DavidZamoraB/faronet/docs/kickoff/Kickoff_FaroNet.docx

Tecnológico de Costa Rica

Ingeniería en Computación · Redes de Computadoras

Proyecto 1: FaroNet

Documento de kick-off

Profesor: Kevin Moraga

Integrantes: David Zamora, Diego Zamora

Octubre, 2026

# 1. Introducción

FaroNet es una red de comunicación construida desde el hardware hasta la aplicación, cuyo objetivo es que las personas puedan conversar sin revelar quién habla con quién. Hoy no basta con cifrar el contenido de un mensaje: los metadatos (origen, destino, hora, frecuencia) también exponen a las personas, y el proyecto busca protegerlos.

El proyecto pide cuatro piezas que se apoyan una sobre otra:

1. El Faro: un dispositivo soldado que transmite y recibe datos usando luz, conectado por USB a una computadora.
2. Un protocolo de enlace propio: tramas de máximo 128 bytes con verificación de errores, control de acceso al medio, versión y una dirección física que puede rotarse.
3. Una red mesh anónima (FaroNet): enruta paquetes por Ethernet, WiFi o el Faro, con cifrado por capas (tipo onion routing) para que ningún nodo intermedio conozca a la vez el origen y el destino.
4. Una salida a Internet en el edge: un gateway que publica solo los mensajes públicos en Cloudflare Workers (salas en tiempo real, feeds, buzón muerto y directorio de nodos), sin guardar datos que identifiquen a los usuarios.

Todo el diseño se documenta en un RFC con consideraciones de privacidad y de seguridad.

## Estrategia de solución

El equipo parte con poca experiencia en casi todas las áreas del proyecto (ver sección 2). Por eso la estrategia es construir de abajo hacia arriba, validando cada capa antes de pasar a la siguiente, y aprender cada tema justo antes de necesitarlo:

1. Fase 0: aprendizaje base (electrónica, Arduino, sockets, criptografía con bibliotecas).
2. Fase 1: prototipo del Faro en protoboard, luz entre dos Faros.
3. Fase 2: Capa 1 (trama, CRC, acceso al medio) y medición de tasa y BER.
4. Fase 3: Faro soldado en perfboard, con pruebas de multímetro.
5. Fase 4: FaroNet (mesh sobre TCP/IP, directorio de nodos, onion routing).
6. Fase 5: gateway (Raspberry Pi) y Cloudflare Workers.
7. Fase 6: RFC, documentación y ensayo de la defensa.

El modelo de amenazas se trabaja en paralelo desde el inicio, porque condiciona las decisiones de todas las fases.

# 2. Diagnóstico de conocimientos del equipo

Ninguno de los dos integrantes ha trabajado antes en la mayoría de las áreas que exige el proyecto. La única base previa es conceptual: la idea general de onion routing, conocida por lo visto en clase.

Área | Peso | Conocimiento actual | Temas por aprender
Hardware (Faro soldado) | 25 % | Ninguno | Transistor como driver, fotodetectores, microcontroladores, soldadura, multímetro, esquemáticos
Capa 1 (protocolo físico) | 10 % | Ninguno | Codificación de línea, sincronización, detección de errores (CRC), acceso al medio, direccionamiento, comunicación serial
Capas 2 y 3 (mesh) | 15 % | Ninguno | Enrutamiento dinámico, circuitos virtuales, overlay sobre TCP/IP, directorio de nodos firmado
Privacidad | 10 % | Conceptual (onion routing) | Criptografía aplicada con bibliotecas (PyNaCl/libsodium), padding, zeroization, modelo de amenazas
Capa 7 anónima | 5 % | Casi nulo | Aplicación de chat/microblogging sobre la mesh, cliente de terminal
Capa 7 en el edge | 25 % | Casi nulo | Cloudflare Workers, Durable Objects, WebSockets, KV/D1/R2, feeds Atom/RSS, firmas, wrangler
RFC | 5 % | Casi nulo | Formato RFC 7322, palabras normativas (RFC 2119), privacidad (RFC 6973)

Esto implica que una parte importante del tiempo se dedicará a aprendizaje. Las horas de estudio se registrarán en las bitácoras de cada integrante.

# 3. Ambiente de desarrollo

Se eligen herramientas comunes y bien documentadas, priorizando las que tienen más material para principiantes. La selección es preliminar y puede ajustarse al definir el hardware.

## Software

Uso | Herramienta
Sistema operativo | GNU/Linux (Ubuntu) en los nodos; Raspberry Pi OS en el gateway
Editor | Visual Studio Code
Firmware del Faro | Arduino (C/C++) con Arduino IDE o PlatformIO
Nodos, DispositivoLuzAdaptador y gateway | Python 3 con pyserial, PyNaCl (libsodium) y Scapy
Aplicación en el edge | TypeScript sobre Cloudflare Workers (plan gratuito), wrangler y Node.js
Esquemático | KiCad (o Fritzing como alternativa)
Documentación y RFC | Markdown convertido a PDF con Pandoc; RFC en texto ASCII

## Hardware y herramientas físicas

- Cautín con control de temperatura, estaño con resina, malla desoldante y soporte para la placa.
- Multímetro digital (continuidad, voltajes y verificación de cortos entre VCC y GND).
- Protoboard y cables para el prototipado; perfboard y headers para la versión final.
- Raspberry Pi para el gateway.

## Forma de debugging

- Faro: monitor serial de Arduino, LEDs indicadores TX/RX y mediciones con multímetro.
- Protocolo y red: mensajes temporales en consola durante el desarrollo (sin guardarlos, por la política de no registro) y Wireshark para el tráfico TCP/IP.
- Edge: wrangler dev para pruebas locales y wrangler tail para ver errores en vivo, sin guardar IPs ni encabezados.

## Flujo de trabajo con Git

- Rama main estable, que siempre compila.
- Una rama por funcionalidad (por ejemplo feature/capa1-crc), integrada con pull request revisado por el otro integrante.
- Mensajes de commit descriptivos, útiles para el reporte de commits de la autoevaluación.
- Archivo .gitignore para excluir secretos y llaves; los secretos del Worker se cargan con wrangler secret.

# 4. Control de versiones

El repositorio se alojará en GitHub con la siguiente estructura.

Enlace al repositorio: https://github.com/DavidZamoraB/faronet

faronet/

firmware/ código Arduino del Faro

adaptador/ biblioteca DispositivoLuzAdaptador

nodo/ nodos de la mesh y cliente de terminal

gateway/ puente FaroNet <-> edge (Raspberry Pi)

worker/ Cloudflare Worker + wrangler.toml

hardware/ esquemático, BOM, fotos y bitácora de pruebas

docs/ documentación y RFC

# 5. Diseño

## Esquemático preliminar del Faro (omitido)

En este kick-off no se presenta el esquemático preliminar del Faro. El equipo no tiene experiencia previa con electrónica: transistores, fotodetectores, microcontroladores ni soldadura. Proponer valores de resistencias, el tipo de receptor o el circuito de acondicionamiento sin esa base produciría un diseño sin fundamento técnico, que probablemente habría que descartar.

Se opta por entregar primero un esquemático correcto, en lugar de uno apresurado:

1. Estudiar los fundamentos (ley de Ohm, LED con resistencia, transistor como interruptor, fotodetectores y comparador).
2. Armar y probar prototipos en protoboard con el microcontrolador elegido.
3. Dibujar el esquemático en KiCad a partir del prototipo que funcione, junto con el BOM en colones.

Los componentes mínimos que exige el enunciado sí están identificados: microcontrolador, emisor de luz con resistencia y driver, receptor de luz con acondicionamiento, LEDs TX/RX, botón de pánico y conexión USB a la computadora del nodo.

## Diagrama de componentes del sistema

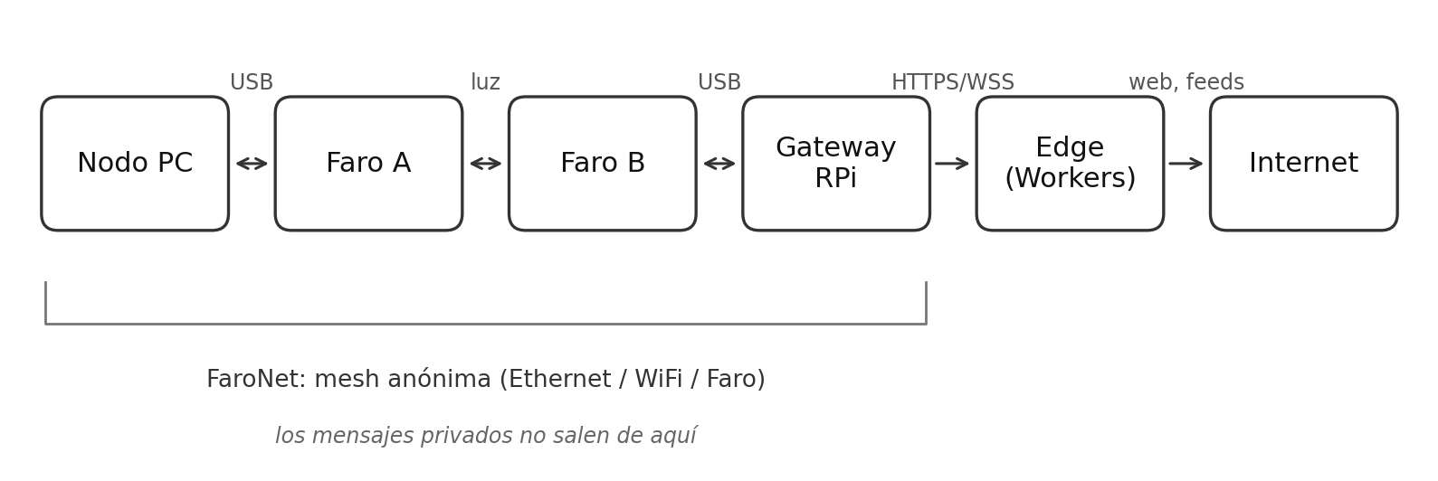
[picture p5: figure]
Nodo PC, Faro A, Faro B, Gateway, Edge e Internet

Las dos comunidades se comunican solo a través de los Faros. Los mensajes privados se quedan dentro de FaroNet; el gateway envía al edge únicamente los públicos.

## Borrador del modelo de amenazas

El objetivo es que ningún adversario individual pueda saber a la vez quién envía un mensaje y a quién. Este borrador se refinará conforme se avance en cada capa.

Adversario | Qué puede ver | Qué no debería ver | Mitigación prevista
Nodo malicioso de la mesh | Salto anterior y siguiente; tamaño y hora de los paquetes | Origen y destino a la vez; contenido | Onion routing de 3+ saltos; padding a tamaño fijo
Observador del medio físico | Que hay transmisión, cuándo, y la dirección física del Faro | Contenido de las tramas | Cifrado extremo a extremo; rotación de la dirección física
Operador del gateway | Mensajes públicos que salen a Internet y su hora | Autor de los mensajes; contenido de los privados | Los privados no salen de FaroNet; el gateway recibe mensajes ya anonimizados
Proveedor del edge | IP del gateway y de navegadores, horas de acceso, tamaño de peticiones | Contenido del buzón muerto; mensajes privados | Blobs cifrados de tamaño fijo con TTL; el Worker no guarda IP ni User-Agent
Robo del Faro | Llaves y estado guardados en memoria | Nada, si se activa el botón de pánico | Botón de pánico que borra llaves y estado sensible

Riesgo aceptado por ahora: el proveedor del edge sigue viendo metadatos de red aunque el Worker no los guarde. Se discutirá en el RFC.
