DavidZamoraB/faronet/(commit log)

2026-10-01 docs: actualizar documento de kickoff
2026-10-16 Faro: hardware, firmware y biblioteca DispositivoLuzAdaptador (Capa 1)
    - firmware/faro: Manchester con preambulo/SFD y deteccion de polaridad,
    trama v1 (max 128 B, CRC-16), CSMA/CA con ACK y reintentos, direccion
    fisica rotable en EEPROM, boton de panico, protocolo serial COBS.
    - adaptador/: biblioteca Python, cliente de terminal `faro`, simulador de
    Faros, medicion de tasa efectiva y BER, capa Scapy y pruebas.
    - hardware/: esquematico, BOM en colones, guia de placa perforada y
    bitacora de pruebas con multimetro.
    - docs/capa1-protocolo.md: especificacion base para el RFC.
2026-10-16 CI: pruebas de la biblioteca y compilacion del firmware
2026-10-17 Mesh FaroNet: circuitos onion, ruteo dinamico y directorio firmado (Capas 2, 3 y 7)
    - Celdas de tamano fijo (512 B) con version y LON.
    - Circuitos negociados de 3 a 5 saltos: handshake tipo ntor (X25519) y una
    capa XChaCha20-Poly1305 por salto, con relleno para mantener el tamano.
    - Ruteo por vector de distancias con envenenamiento en reversa.
    - Directorio de nodos con entradas firmadas (Ed25519) difundidas por la mesh.
    - Mensajes cifrados de extremo a extremo (SealedBox) de tamano fijo, buzon con TTL.
    - Enlaces TCP y Faro (fragmenta celdas en tramas de 114 B sobre DispositivoLuzAdaptador).
    - Boton de panico: borra llaves y estado del nodo.
    - Cliente de terminal `faronet`, demo local y pru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
    [cli.py]
2026-10-17 Worker en el edge: salas publicas, feeds, buzon muerto y directorio (Capa 7)
    - Cloudflare Worker (plan gratuito, Durable Objects SQLite):
    - Relay del gateway con firmas Ed25519 y marca de tiempo creciente (anti-replay).
    - Salas publicas en tiempo real por tema (WebSockets con hibernacion) y feed Atom.
    - Buzon muerto: blobs cifrados de 1024 B, TTL y lectura unica atomica.
    - Replica publica del directorio con firmas verificadas y entradas crudas.
    - Limite de peticiones con clave hasheada; sin logs ni IPs persistidas.
    - Paginas con CSP estricta (nonce).
    - gateway/: cliente Python firmado (faronet-edge) y buzon cifrado del lado cliente.
    - Pruebas de integracion contra wrangler dev y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
2026-10-17 Puente mesh -> edge: mensajes publicos por circuito onion y directorio al Worker
    - Comando de rele PUBLICAR/PUBLICADO: el circuito termina en un gateway, que
    recibe un MensajePublico de tamano fijo (391 B) sin conocer al origen.
    - Nodo.publicar() y comando `publicar <tema> <texto>` en la consola.
    - gateway/faronet_gateway/puente.py: sube los mensajes publicos al Worker y
    sincroniza el directorio de la mesh cada 5 minutos (`faronet --gateway --edge URL`).
    - Pruebas: mensajes publicos en la mesh y prueba de punta a punta
    mesh -> gateway -> Worker (wrangler dev).
    - Las pruebas del Worker terminan todo el grupo de procesos de wrangler.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
2026-10-24 Hardware: receptor probado por Diego (umbral fijo R9/R10, R4 1,5 MΩ, R5 10 kΩ)
    - esquematico.md: el trimpot RV1 se reemplaza por un divisor fijo 10 kΩ / 1 kΩ
    (umbral ≈ 0,45 V), R4 pasa a 1,5 MΩ y R5 a 10 kΩ. Tabla para ajustar R10,
    notas sobre Nano/Uno/Pro Mini y la Raspberry Pi como nodo.
    - bom.md: componentes y totales actualizados, tabla de cambios y notas de compra.
    - placa_perforada.md, bitacora_pruebas.md, README.md: sin RV1, mediciones
    esperadas con el divisor fijo.
    - calibrar_receptor.py: script de prueba del umbral que Diego uso en protoboard.
    Claude-Session: https://claude.ai/code/session_019DU8MxJ8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
2026-11-01 Worker desplegado en Cloudflare: llave del gateway y User-Agent propio
    - worker/wrangler.toml: GATEWAYS con la llave publica del gateway de la
    Raspberry Pi (faronet-gw).
    - gateway/edge.py: el cliente se identifica como "faronet-gateway/0.1";
    Cloudflare rechaza el User-Agent por defecto "Python-urllib" (error 1010)
    y bloqueaba todas las peticiones del gateway.
    - worker/README.md: URL del despliegue y prueba de punta a punta.
    Probado en https://faronet.faronet-worker.workers.dev: salud, salas, buzon
    muerto, publicar firmado, directorio y la cadena completa cliente -> onion
    por la Pi -> gateway -> Worker -> #general.
2026-11-01 RFC de FaroNet: Capa 1 (Faro), mesh anonima y edge
    docs/rfc-faronet.txt, en ASCII y con lineas de 72 columnas (RFC 7322):
    - Capa 1: Manchester, sincronizacion, trama de 128 bytes con CRC-16,
    direcciones fisicas rotables, CSMA/CA con ACK y tramas externas.
    - Protocolo serial nodo-Faro (DispositivoLuzAdaptador).
    - FaroNet: identidad, celdas de 512 bytes, enlaces TCP y Faro,
    vector de distancias, directorio firmado, circuitos ntor de 3 a 5
    saltos y capas XChaCha20-Poly1305.
    - Capa 7 en la mesh (privados y publicos) y en el edge (relay
    firmado, salas, feeds, buzon muerto, directorio, limites).
    - Versionado, modelo de amenazas, Consideraciones de Privacidad
    (RFC 6973) y de Seguridad.
    -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
2026-11-01 Temas privados: residen unicamente dentro de FaroNet
    El enunciado pide que los mensajes privados y los temas marcados como
    privados no salgan de FaroNet.
    - mensaje.py: TIPO TEMA_PRIVADO (0x02). Despues del ALIAS van LON_TEMA y
    TEMA, dentro del sobre sellado: ni los reles ni el gateway ven el tema.
    El sobre mide lo mismo (391 bytes) que un mensaje privado normal.
    - nodo.py: crear_tema_privado() y enviar_tema(). Cada mensaje del tema
    viaja a cada miembro como mensaje privado por su propio circuito.
    publicar() rechaza los temas privados. La lista de miembros vive solo
    en memoria y el panico la borra.
    - cli.py: comandos "tema crear | enviar | ver"; el buzon y los avisos
    muestran el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
2026-11-02 Documentacion del proyecto: Markdown fuente y PDF con el RFC anexo
    Sigue las 10 secciones del enunciado. Lo que falta (mediciones, horas,
    autoevaluacion, fotos, KiCad) queda marcado como [PENDIENTE].
    docs/generar_pdf.sh regenera el PDF con pandoc y Chromium.
    Claude-Session: https://claude.ai/code/session_018GiJpLVQzZMfXhcZpEjMoy
2026-11-02 Documentacion: pruebas Faro a Faro no realizadas y fotos de las placas
    Las pruebas entre dos Faros y la medicion de tasa/BER a tres distancias
    no se pudieron hacer: quedan como no realizadas en la documentacion y en
    el Apendice B del RFC. Se agregan las fotos de ambas caras de las dos
    placas (hardware/fotos/) y se regenera el PDF.
    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
2026-11-02 Faro manejado por una Raspberry Pi por GPIO (sin Arduino)
    Cada Faro lo controla ahora una Raspberry Pi directamente por sus pines.
    La capa 1 es la misma del RFC: Manchester, CSMA/CA con ACK, CRC,
    direccion fisica rotable, boton de panico y LEDs TX/RX/estado.
    - adaptador/faro_gpio.py: FaroGPIO hereda la logica de comandos de
    FaroSimulado (mismo protocolo serial que el firmware) y cambia el medio
    simulado por luz real con pigpio: tramas como formas de onda por DMA y
    flancos del receptor con marca de tiempo en microsegundos, asi que la
    latencia de Linux no afecta la decodificacion. Ignora el eco de su propio
    LED, filtra duplicados y guarda direccion y secreto en un archivo 0600
    que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
2026-11-02 Documentacion: autoevaluacion de aprendizaje (seccion 7.5)
2026-11-02 Disenos de la placa perforada (Faro 1 y Faro 2)
    hardware/placa/placa.py: distribucion real del Faro 1 tal como quedo
    soldado (con las reubicaciones del LED rojo, LED verde, 1,5 MOhm y boton).
    hardware/placa/placa2.py: diseno limpio para el Faro 2 con las lecciones
    aplicadas. Ambos verifican conexiones, cortos y patas libres:
    "python3 hardware/placa/placa.py" -> 16 redes, 21 componentes, 0 errores.
2026-11-02 Documentacion y RFC: el Faro lo controla una Raspberry Pi por GPIO
    - documentacion.md/.pdf: ambiente, seccion 3.1 (diagrama, tabla de pines
    J1 <-> Raspberry, por que Raspberry, pigpio, niveles de 3,3 V y divisor),
    cambios de piezas (R1 100 Ohm, C1 10 nF, controlador, divisor), estado
    del Faro 1, faro_gpio.py en la biblioteca, instrucciones con
    "faro -p gpio" y "faronet --faro gpio", y estado final. El Arduino queda
    como alternativa.
    - rfc-faronet.txt: terminologia y diagrama con Raspberry y GPIO, memoria
    no volatil (archivo en la SD o EEPROM), Capa 1 en la misma Raspberry
    con pigpio, nivel de 3,3 V, panico y limites de borrar en una SD.
    Sigue en ASCII con lineas de 72 columna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
2026-11-02 Faro por GPIO: loopback y correccion del retraso del sensor
    Probado con el Faro 1 soldado y la Raspberry Pi 2.
    - Loopback (probar_loopback + hardware/loopback_gpio.py): un solo Faro
    emite tramas y las lee con su propio sensor (reflejo), y mide tramas
    buenas, con errores y perdidas, BER y tasa efectiva. Con la superficie a
    1-2 cm: 2000 bit/s 50/50 tramas sin errores (1568 bit/s utiles) y hasta
    20000 bit/s sin errores (10053 bit/s utiles).
    - Con poca luz el fototransistor tarda mas en apagarse: la luz llegaba
    115 us mas larga (615/385 us en vez de 500/500 a 2000 bit/s) y se
    perdian todas las tramas. El DecodificadorManchester ahora mide ese sesgo
    en el preambulo 0x55 (periodos d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
    [faro_gpio.py, loopback_gpio.py, test_faro_gpio.py]
2026-11-03 Pruebas del Faro GPIO: la Raspberry falsa acepta pigpio.pulse
    Con pigpio instalado, FaroGPIO arma pigpio.pulse en vez de tuplas, y la
    Raspberry falsa de las pruebas no los sabia leer (5 errores en faronet-sur).
    [test_faro_gpio.py]
